danielecostarella/energy-harvesting-demoboard/hardware/PDF/energy-harvesting-demoboard_brd_v11.pdf

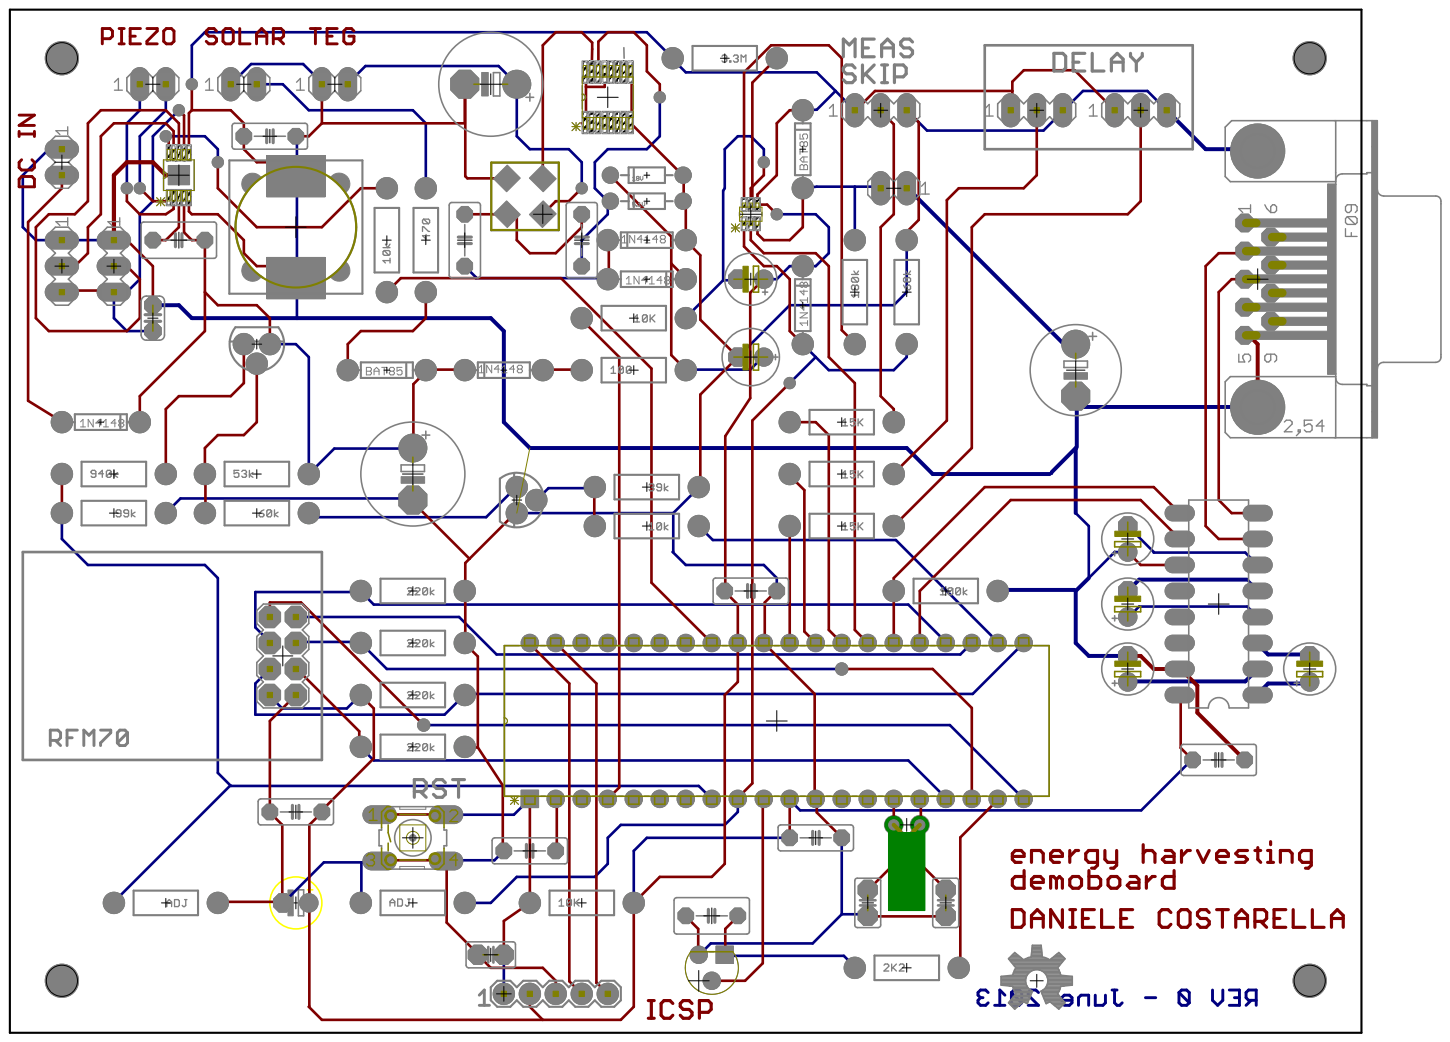
[picture p1: page 1]
