danielecostarella/energy-harvesting-demoboard/hardware/PDF/energy-harvesting-demoboard_v11.pdf

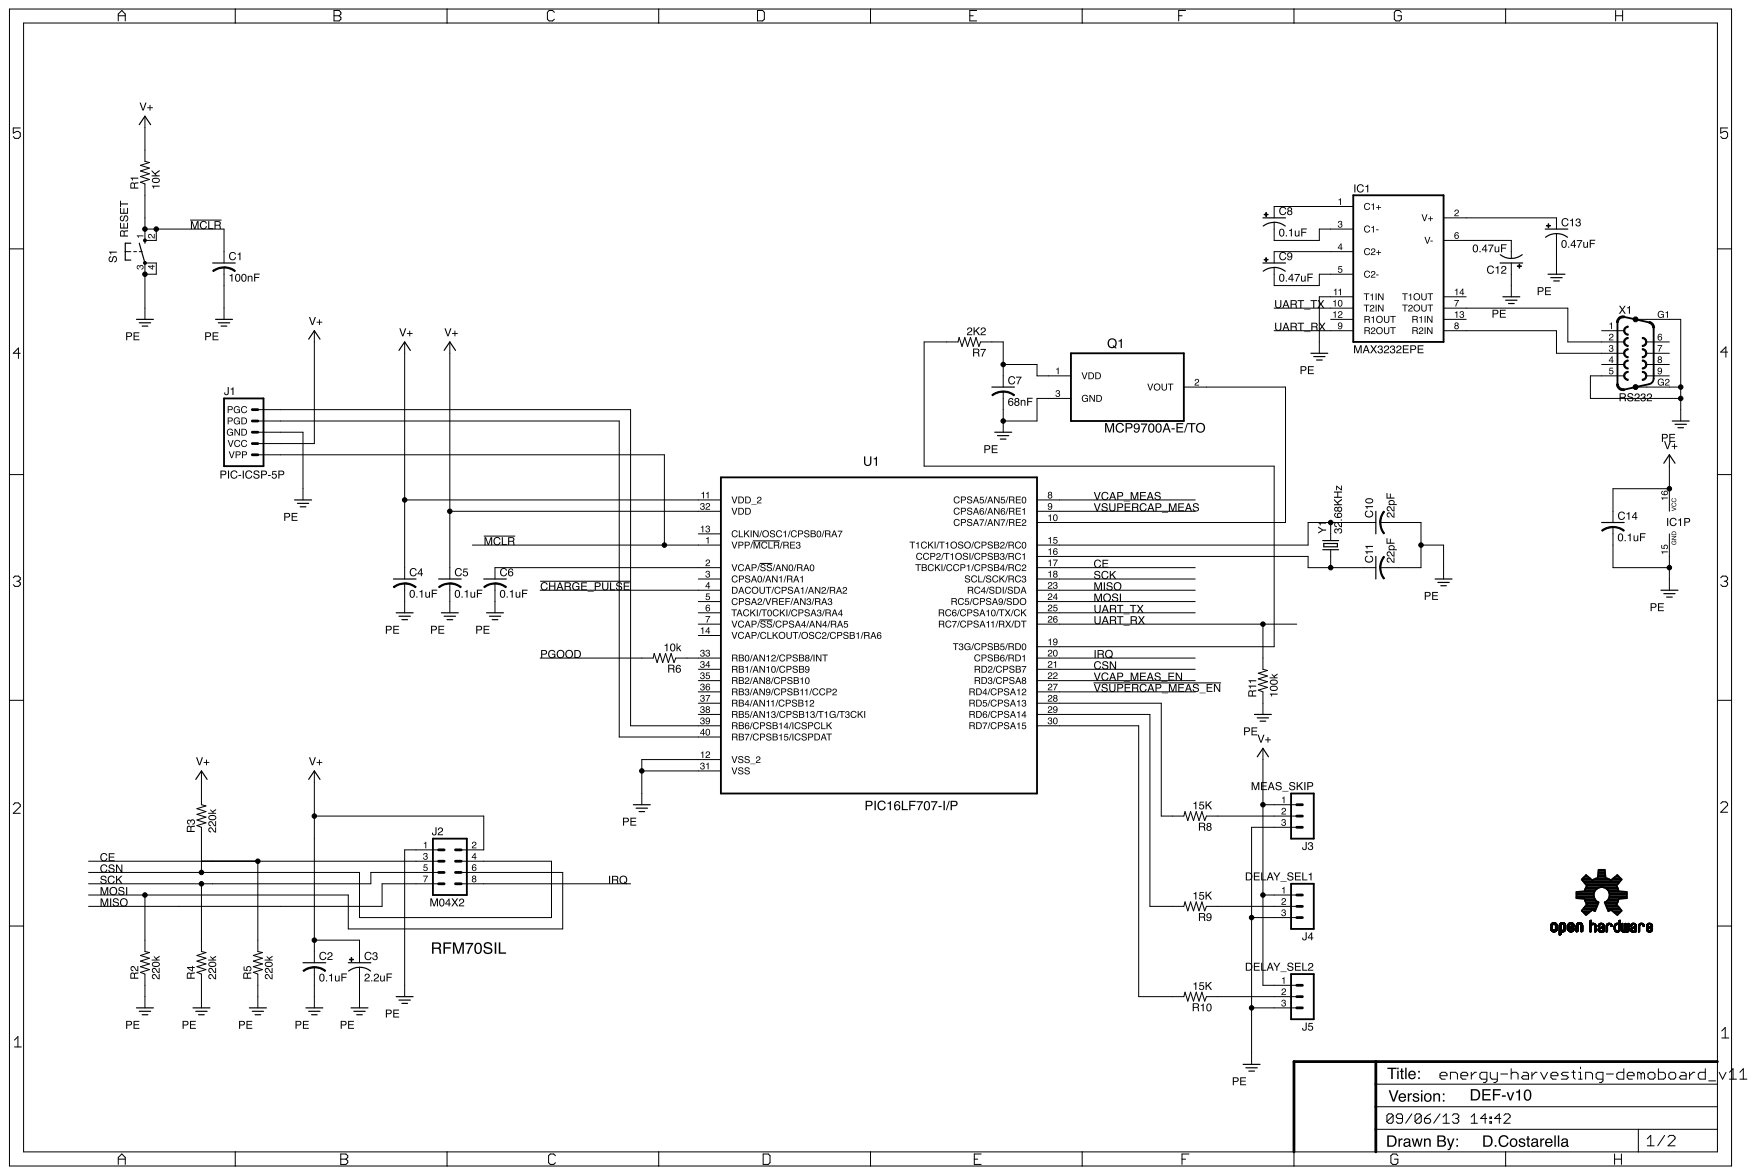
[picture p2: page 1]

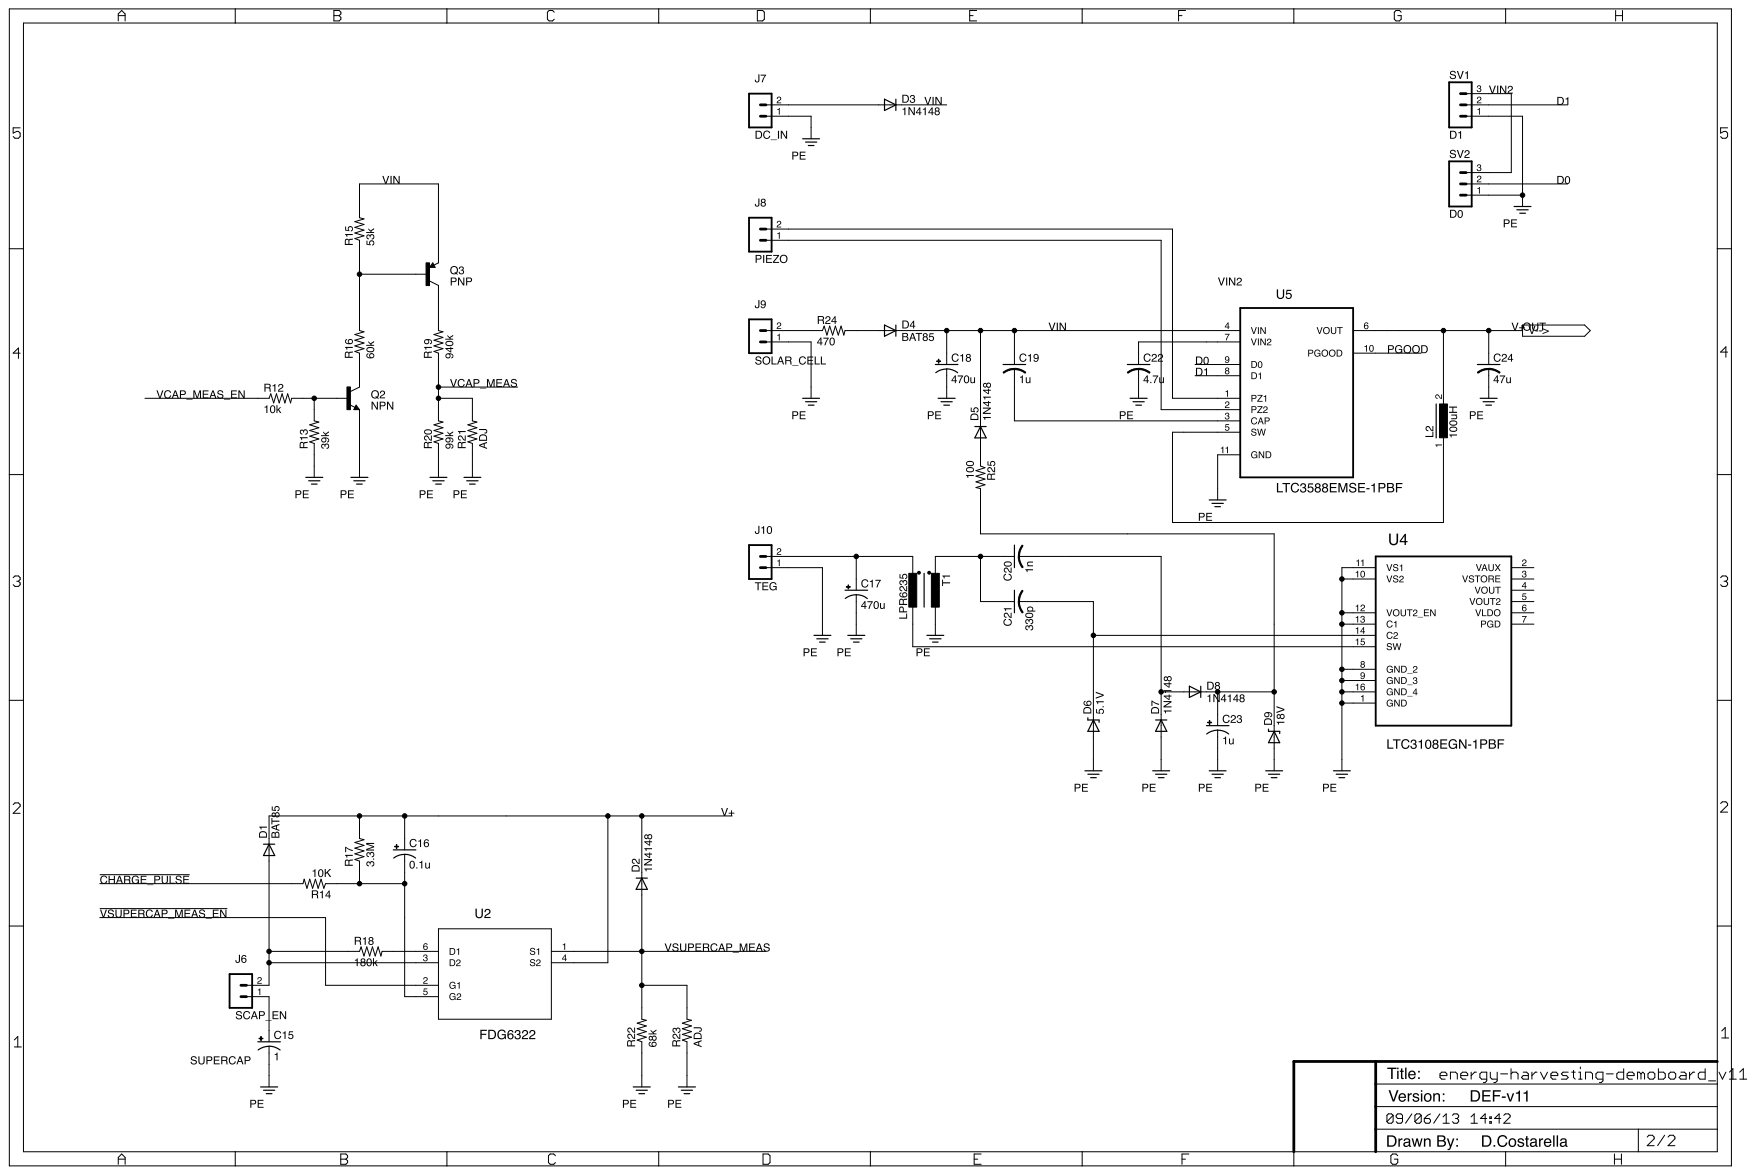
[picture p3: page 2]
