danielecostarella/energy-harvesting-demoboard/hardware/EAGLE/energy-harvesting-demoboard_v11.brd

## EAGLE design hardware/EAGLE/energy-harvesting-demoboard_v11.brd (2018-03-24)

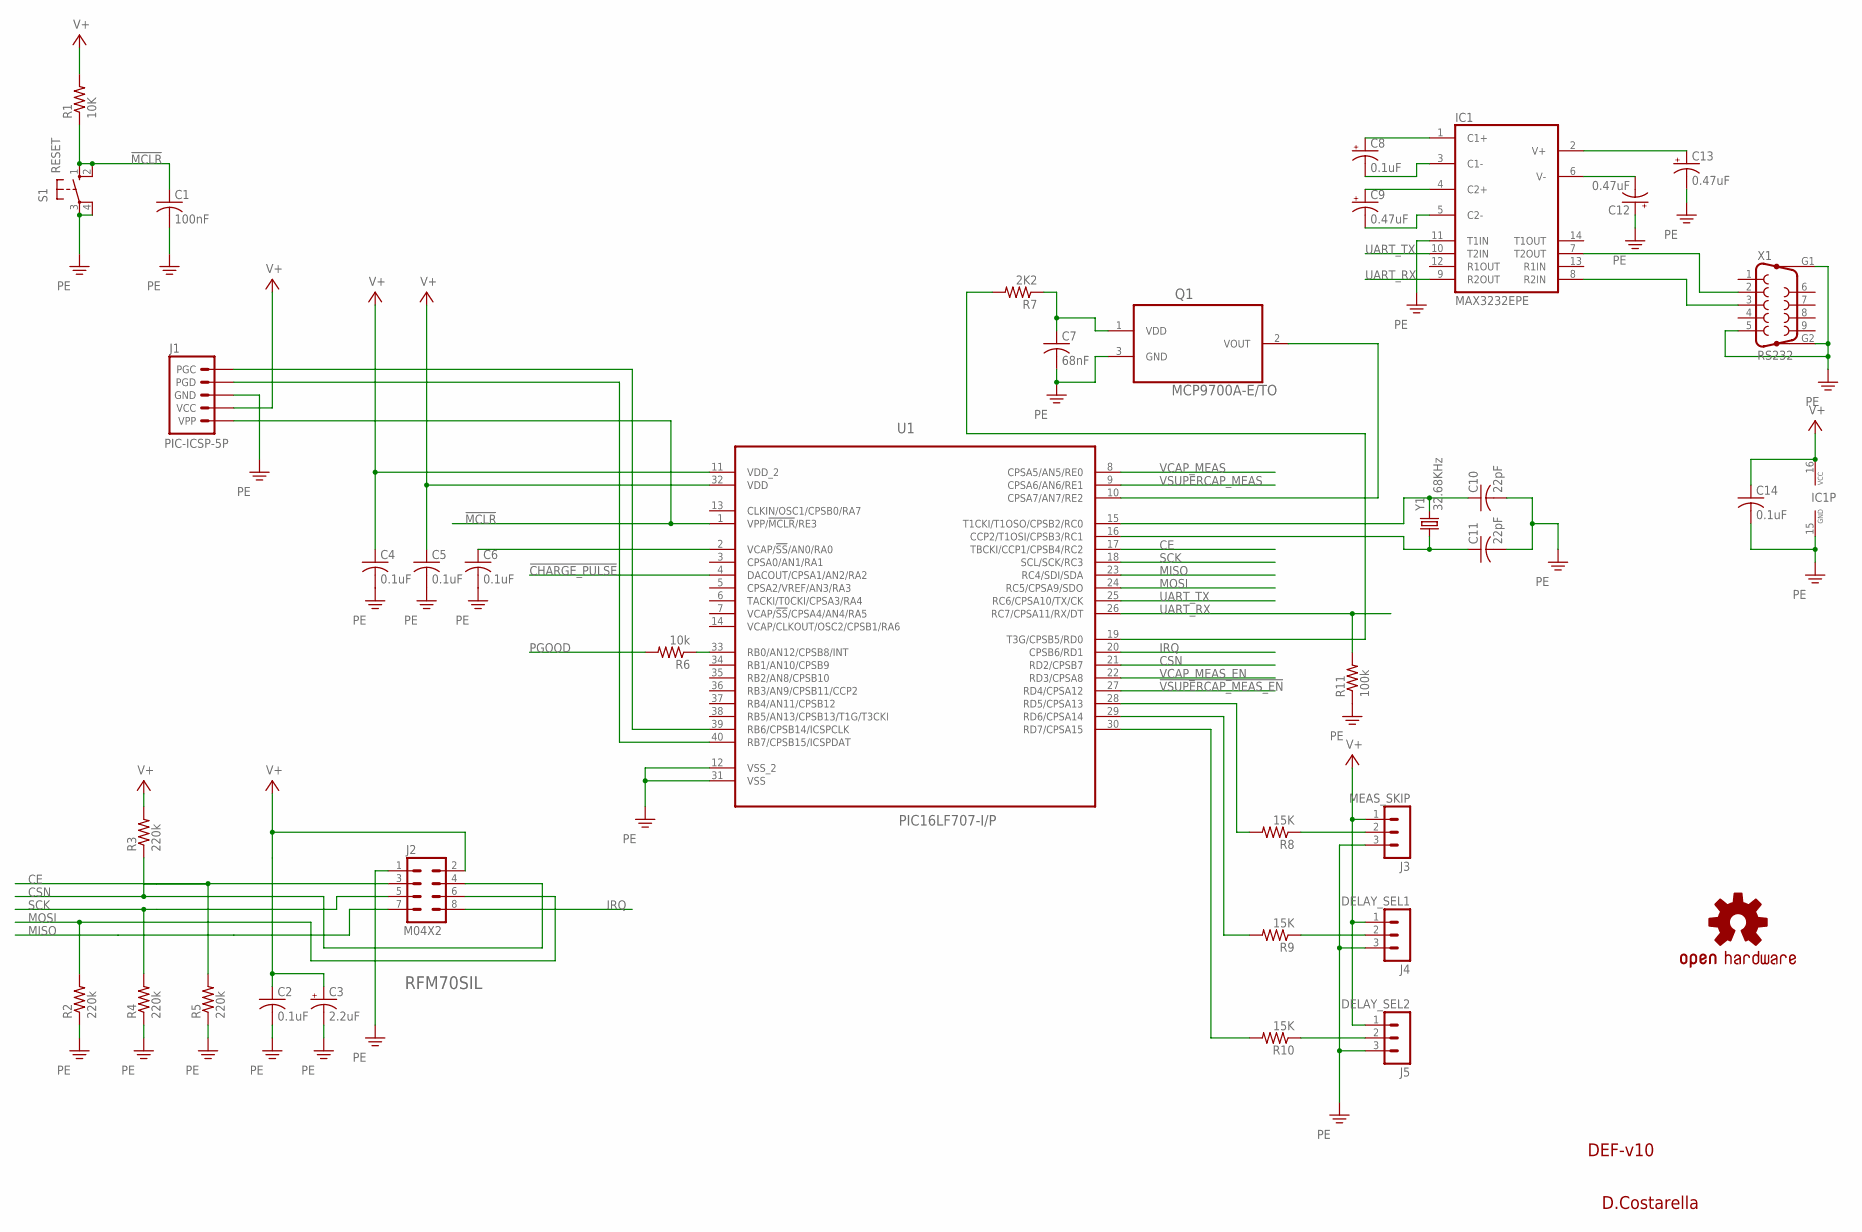
[picture p4: schematic energy-harvesting-demoboard_v11.sch, sheet 1]

Parts:
C1: 100nF; C025-025X050
C2, C4, C5, C6: 0.1uF; C050-025X075
C3: 2.2uF; E2,5-5
C7: 68nF; C050-035X075
C8: 0.1uF; E2,5-5
C9, C12, C13: 0.47uF; E2,5-5
C10, C11: 22pF; C025-025X050
C14: 0.1uF; C050-030X075
IC1: MAX3232EPE; DIL16
J1: PIC-ICSP-5P; 1X05
J2: M04X2; 2X4
J3: MEAS_SKIP; MA03-1
J4: DELAY_SEL1; MA03-1
J5: DELAY_SEL2; MA03-1
LOGO1: OSHW-LOGOL; OSHW-LOGO-L
Q1: MCP9700A-E/TO; TO127P254X533-3
R1: 10K; AXIAL-0.4
R2, R3, R4, R5: 220k; AXIAL-0.4
R6: 10k; AXIAL-0.4
R7: 2K2; AXIAL-0.4
R8, R9, R10: 15K; AXIAL-0.4
R11: 100k; AXIAL-0.4
S1: RESET; B3F-10XX
U1: PIC16LF707-I/P; DIP254P1524X635-40
X1: RS232; F09HP
Y1: 32.68KHz; TC26HEZ

Connections:
!CHARGE_PULSE: U1.4 (DACOUT/CPSA1/AN2/RA2); also elsewhere on the board
!MCLR: C1.1, J1.1 (VPP), R1.P$1 (1), S1.1 (S), S1.2 (S1), U1.1 (VPP/!MCLR!/RE3)
!VSUPERCAP_MEAS_EN: U1.27 (RD4/CPSA12); also elsewhere on the board
CE: J2.3, R5.P$2 (2), U1.17 (TBCKI/CCP1/CPSB4/RC2)
CSN: J2.4, R3.P$1 (1), U1.21 (RD2/CPSB7)
IRQ: J2.8, U1.20 (CPSB6/RD1)
MISO: J2.7, U1.23 (RC4/SDI/SDA)
MOSI: J2.6, R2.P$2 (2), U1.24 (RC5/CPSA9/SDO)
unnamed: J1.5 (PGC), U1.39 (RB6/CPSB14/ICSPCLK)
unnamed: J1.4 (PGD), U1.40 (RB7/CPSB15/ICSPDAT)
unnamed: C6.1, U1.2 (VCAP/!SS!/AN0/RA0)
unnamed: C10.1, U1.15 (T1CKI/T1OSO/CPSB2/RC0), Y1.2
unnamed: C11.1, U1.16 (CCP2/T1OSI/CPSB3/RC1), Y1.1
unnamed: Q1.2 (VOUT), U1.10 (CPSA7/AN7/RE2)
unnamed: J3.2, R8.P$1 (1)
unnamed: R8.P$2 (2), U1.28 (RD5/CPSA13)
unnamed: J4.2, R9.P$1 (1)
unnamed: J5.2, R10.P$1 (1)
unnamed: R9.P$2 (2), U1.29 (RD6/CPSA14)
unnamed: R10.P$2 (2), U1.30 (RD7/CPSA15)
unnamed: C7.1, Q1.1 (VDD), R7.P$1 (1)
unnamed: C8.+, IC1.1 (C1+)
unnamed: C8.-, IC1.3 (C1-)
unnamed: C9.+, IC1.4 (C2+)
unnamed: C9.-, IC1.5 (C2-)
unnamed: C12.-, IC1.6 (V-)
unnamed: C13.+, IC1.2 (V+)
unnamed: IC1.8 (R2IN), X1.3
unnamed: IC1.7 (T2OUT), X1.2
unnamed: R6.P$1 (1), U1.33 (RB0/AN12/CPSB8/INT)
PE: C1.2, C2.2, C3.-, C4.2, C5.2, C6.2, C7.2, C10.2, C11.2, C12.+, C13.-, C14.2, IC1.11 (T1IN), IC1.15 (GND), J1.3 (GND), J2.1, J3.3, J4.3, J5.3, Q1.3 (GND), R2.P$1 (1), R4.P$1 (1), R5.P$1 (1), R11.P$1 (1), S1.3, S1.4 (P1), U1.12 (VSS_2), U1.31 (VSS), X1.5, X1.G1, X1.G2; also elsewhere on the board
PGOOD: R6.P$2 (2); also elsewhere on the board
SCK: J2.5, R4.P$2 (2), U1.18 (SCL/SCK/RC3)
SENS_EN: R7.P$2 (2), U1.19 (T3G/CPSB5/RD0)
UART_RX: IC1.9 (R2OUT), R11.P$2 (2), U1.26 (RC7/CPSA11/RX/DT)
UART_TX: IC1.10 (T2IN), U1.25 (RC6/CPSA10/TX/CK)
V+: C2.1, C3.+, C4.1, C5.1, C14.1, IC1.16 (VCC), J1.2 (VCC), J2.2, J3.1, J4.1, J5.1, R1.P$2 (2), R3.P$2 (2), U1.11 (VDD_2), U1.32 (VDD); also elsewhere on the board
VCAP_MEAS: U1.8 (CPSA5/AN5/RE0); also elsewhere on the board
VCAP_MEAS_EN: U1.22 (RD3/CPSA8); also elsewhere on the board
VSUPERCAP_MEAS: U1.9 (CPSA6/AN6/RE1); also elsewhere on the board

Notes on the sheet:
DEF-v10
D.Costarella
RFM70SIL

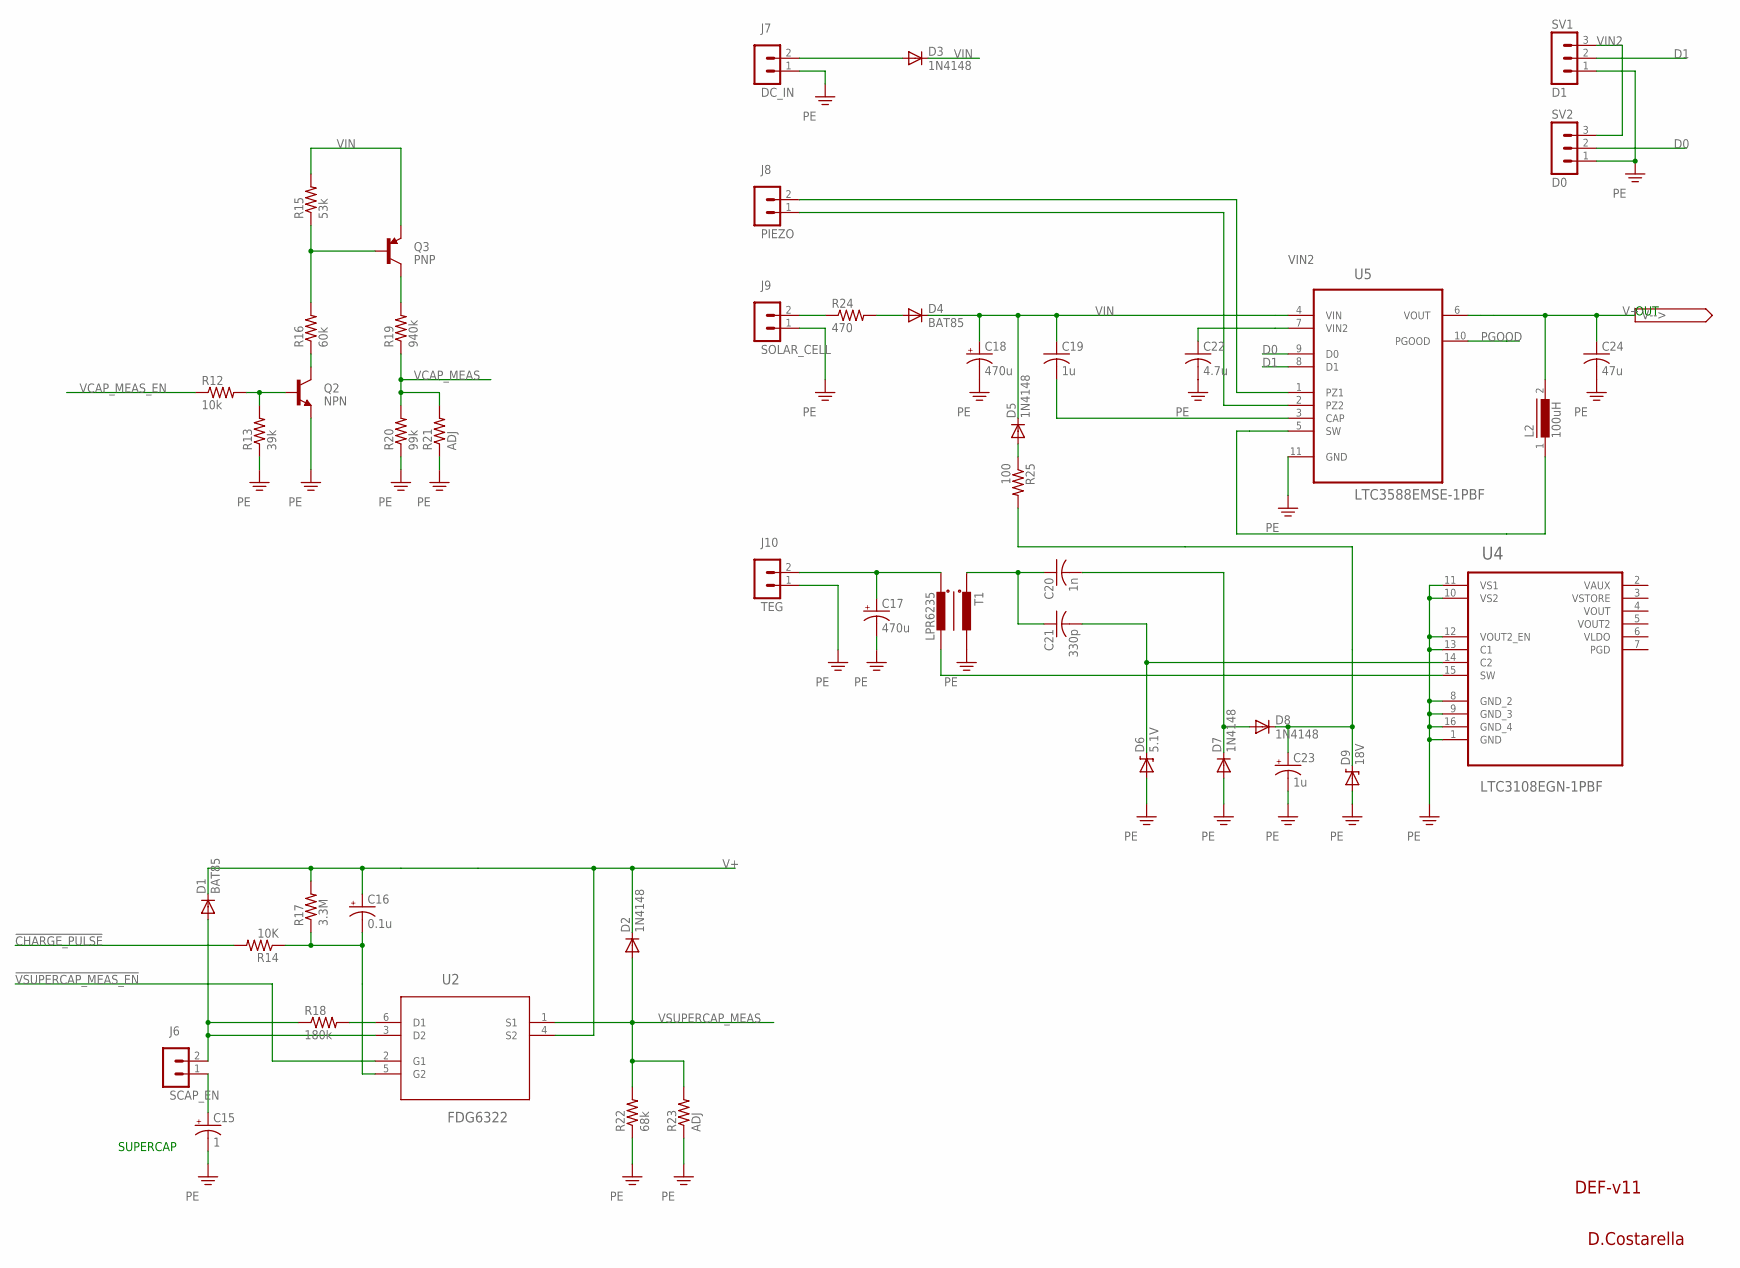
[picture p5: schematic energy-harvesting-demoboard_v11.sch, sheet 2]

Parts:
C15: 1; E5-8,5
C16: 0.1u; E2,5-5
C17, C18: 470u; E5-10,5
C19: 1u; C050-035X075
C20: 1n; C050-030X075
C21: 330p; C050-030X075
C22: 4.7u; C025-024X044
C23: 1u; E2,5-6E
C24: 47u; C050-025X075
D1, D4: BAT85; DIODE-1N4148
D2, D7, D8: 1N4148; DIODE-1N4148
D3, D5: 1N4148; SMA-DIODE
D6: 5.1V; DIODE-ZENER
D9: 18V; DIODE-ZENER
J6: SCAP_EN; MA02-1
J7: DC_IN; MA02-1
J8: PIEZO; MA02-1
J9: SOLAR_CELL; MA02-1
J10: TEG; MA02-1
L2: 100uH; DR125
Q2: NPN; TO-92
Q3: PNP; TO-92
R12: 10k; AXIAL-0.4
R13: 39k; AXIAL-0.4
R14: 10K; AXIAL-0.4
R15: 53k; AXIAL-0.4
R16: 60k; AXIAL-0.4
R17: 3.3M; AXIAL-0.4
R18: 180k; AXIAL-0.4
R19: 940k; AXIAL-0.4
R20: 99k; AXIAL-0.4
R21, R23: ADJ; AXIAL-0.4
R22: 68k; AXIAL-0.4
R24: 470; AXIAL-0.4
R25: 100; AXIAL-0.4
SV1: D1; MA03-1
SV2: D0; MA03-1
T1: LPR6235
U2: FDG6322; SOT65P210X110-6N
U4: LTC3108EGN-1PBF; SOP63P600X175-16N
U5: LTC3588EMSE-1PBF; SOP50P490X110-11N

Connections:
!CHARGE_PULSE: R14.P$2 (2); also elsewhere on the board
!VSUPERCAP_MEAS_EN: U2.2 (G1); also elsewhere on the board
D0: SV2.2, U5.9 (D0)
D1: SV1.2, U5.8 (D1)
unnamed: Q2.2 (B), R12.P$2 (2), R13.P$2 (2)
unnamed: Q2.1 (C), R16.P$1 (1)
unnamed: Q3.2 (B), R15.P$1 (1), R16.P$2 (2)
unnamed: J8.1, U5.2 (PZ2)
unnamed: Q3.3 (C), R19.P$2 (2)
unnamed: D1.A, J6.2, R18.P$1 (1), U2.3 (D2)
unnamed: R18.P$2 (2), U2.6 (D1)
unnamed: J9.2, R24.P$1 (1)
unnamed: J8.2, U5.1 (PZ1)
unnamed: L2.1, U5.5 (SW)
unnamed: C19.2, U5.3 (CAP)
unnamed: C15.+, J6.1
unnamed: C23.+, D8.C, D9.P$1 (C), R25.P$2 (2)
unnamed: C21.2, D6.P$1 (C), U4.14 (C2)
unnamed: D3.A, J7.2
unnamed: C17.+, J10.2, T1.P$1 (1)
unnamed: D5.A, R25.P$1 (1)
unnamed: C20.2, D7.C, D8.A
unnamed: C16.-, R14.P$1 (1), R17.P$1 (1), U2.5 (G2)
unnamed: D4.A, R24.P$2 (2)
unnamed: T1.P$2 (2), U4.15 (SW)
unnamed: C20.1, C21.1, T1.P$4 (4)
PE: C15.-, C17.-, C18.-, C22.2, C23.-, C24.2, D6.P$2 (A), D7.A, D9.P$2 (A), J7.1, J9.1, J10.1, Q2.3 (E), R13.P$1 (1), R20.P$1 (1), R21.P$1 (1), R22.P$1 (1), R23.P$1 (1), SV1.1, SV2.1, T1.P$3 (3), U4.1 (GND), U4.8 (GND_2), U4.9 (GND_3), U4.10 (VS2), U4.11 (VS1), U4.12 (VOUT2_EN), U4.13 (C1), U4.16 (GND_4), U5.11 (GND); also elsewhere on the board
PGOOD: U5.10 (PGOOD); also elsewhere on the board
V+: C16.+, C24.1, D1.C, D2.C, L2.2, R17.P$2 (2), U2.4 (S2), U5.6 (VOUT); also elsewhere on the board
VCAP_MEAS: R19.P$1 (1), R20.P$2 (2), R21.P$2 (2); also elsewhere on the board
VCAP_MEAS_EN: R12.P$1 (1); also elsewhere on the board
VIN: C18.+, C19.1, D3.C, D4.C, D5.C, Q3.1 (E), R15.P$2 (2), U5.4 (VIN)
VIN2: C22.1, SV1.3, SV2.3, U5.7 (VIN2)
VSUPERCAP_MEAS: D2.A, R22.P$2 (2), R23.P$2 (2), U2.1 (S1); also elsewhere on the board

Notes on the sheet:
OUT
SUPERCAP
DEF-v11
D.Costarella

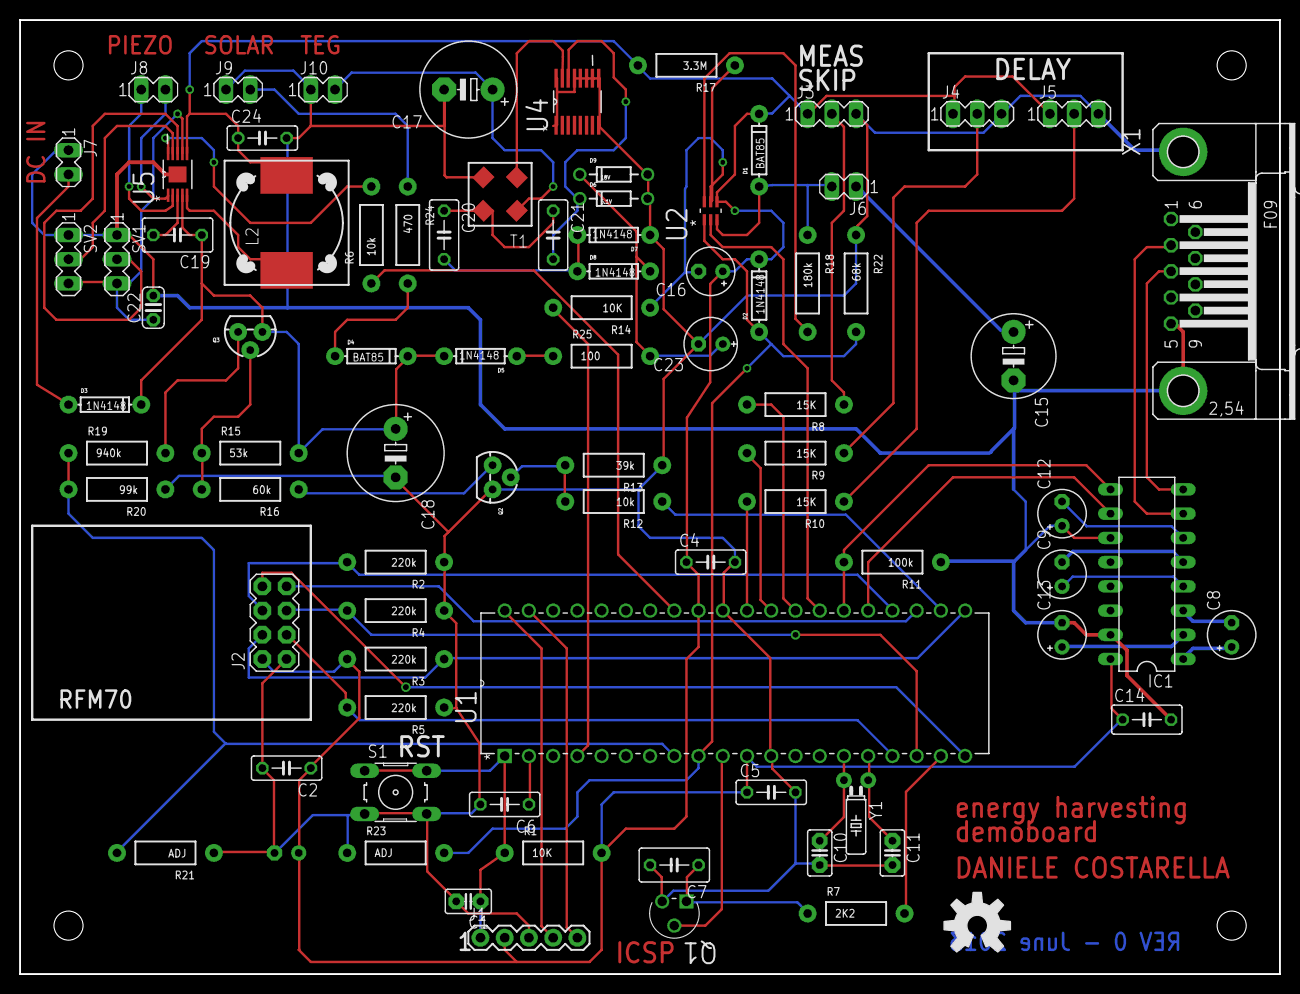
[picture p6: board energy-harvesting-demoboard_v11.brd from above]

Board: 2 copper layers, 132.1 x 100.0 mm, 84 parts (1 on the bottom side), 66 nets.
