danielecostarella/energy-harvesting-demoboard/firmware/rfm70.c

/*****************************************************************************
 * File:        rfm70.c
 *
 * Compiler:    Microchip XC8 v1.12 or higher
 *
 * Released on: June, 2013
 *
 *****************************************************************************
 * File description:
 *
 * Energy Harvesting Demoboard firmware
 * RFM70 radio module driver for PIC16
 *
 * For new versions of this code please visit:
 * https://github.com/danielecostarella/energy-harvesting-demoboard
 *
 * Detailed information can also be found on my master thesis [IT]
 *
 *****************************************************************************/

/********************************** HEADERS **********************************/
#include <stdio.h>
#include <stdlib.h>
#include "rfm70.h"
#include "main.h"


/*****************************************************************************/
// Bank1 register init values
/*****************************************************************************/
const unsigned long Bank1_Reg0_13[]={       //latest config txt
    0xE2014B40,
    0x00004BC0,
    0x028CFCD0,
    0x41390099,
    0x0B869Ef9,
    0xA67F0624,
    0x00000000,
    0x00000000,
    0x00000000,
    0x00000000,
    0x00000000,
    0x00000000,
    0x00127300,
    0x36B48000,
};

const uint8_t Bank1_Reg14[]=
{
	0x41,0x20,0x08,0x04,0x81,0x20,0xCF,0xF7,0xFE,0xFF,0xFF
};


/*****************************************************************************/
// Bank0 register init values
/*****************************************************************************/
const uint8_t Bank0_Reg[][2]={
    {0,0x0F},   // reflect RX_DR\TX_DS\MAX_RT, Enable CRC , 2byte, POWER UP, PRX
    {1,0x3F},   // Enable auto acknowledgement data pipe5\4\3\2\1\0
    {2,0x3F},   // Enable RX Addresses pipe5\4\3\2\1\0
    {3,0x03},   // RX/TX address field width 5 byte
    {4,0xFF},   // auto retransmission delay (4000us),auto retransmission count(15)
    {5,0x17},   // Channel: 23
    {6,0x01},   // air data rate-1M,out power 0dbm,setup LNA gain
    {7,0x07},
    {8,0x00},
    {9,0x00},
    {12,0xc3},  // Only LSB Receive address data pipe 2, MSB bytes is equal to
                // RX_ADDR_P1[39:8]
    {13,0xc4},  // Only LSB Receive address data pipe 3, MSB bytes is equal to
                // RX_ADDR_P1[39:8]
    {14,0xc5},  // only LSB Receive address data pipe 4, MSB bytes is equal to
                // RX_ADDR_P1[39:8]
    {15,0xc6},  // only LSB Receive address data pipe 5, MSB bytes is equal to
                // RX_ADDR_P1[39:8]
    {17,0x20},  // Number of bytes in RX payload in data pipe0 (32 byte)
    {18,0x20},  // Number of bytes in RX payload in data pipe1 (32 byte)
    {19,0x20},  // Number of bytes in RX payload in data pipe2(32 byte)
    {20,0x20},  // Number of bytes in RX payload in data pipe3(32 byte)
    {21,0x20},  // Number of bytes in RX payload in data pipe4(32 byte)
    {22,0x20},  // Number of bytes in RX payload in data pipe5(32 byte)
    {23,0x00},  // FIFO status
    {28,0x3F},  // Enable dynamic payload length data pipe5\4\3\2\1\0
    {29,0x07}   // Enables Dynamic Payload Length,Enables Payload with ACK,Enables
                // the W_TX_PAYLOAD_NOACK command
};

const uint8_t Bank0_RegAct[2][2] = {
    {DYNPD, 0x3F},
    {FEATURE, 0x07}
};
/* Receive address data p0 */
const uint8_t RX0_Address[]={0x34,0x43,0x10,0x10,0x01};

/* Receive address data p1 */
const uint8_t RX1_Address[]={0x39,0x38,0x37,0x36,0xc2};


/*****************************************************************************/
// SPI access
/*****************************************************************************/
uint8_t SPI_RW(uint8_t value)
{
	SSPBUF = value;		// send data via SPI - put in SPI Data Register
        WAIT_MS(1);
	while(!PIR1bits.SSPIF); // wait for SPI interrupt flag indicating
                                // transmit complete
        //WAIT_MS(1);
	return SSPBUF;          // return value in SPI Data Register
}


/*****************************************************************************
 * Function: SPI_Write_Reg()
 * Description:     Writes value 'value' to register 'reg'
 * Parameter:       reg to be write, value
 *
 *
 * Return:          None
 *****************************************************************************/
void SPI_Write_Reg(uint8_t reg, uint8_t value)
{
	CSN=0;                  // CSN low, init SPI transaction
	SPI_RW(reg);     	// select register
	SPI_RW(value);          // ..and write value to it
	CSN=1;                  // Then, CSN high again
}


/*****************************************************************************
 * Function: SPI_Read_Reg()
 * Description:     Read one uint8_t from BK2421 register, 'reg'
 * Parameter:       reg to be read
 *
 *
 * Return:          None
 *****************************************************************************/
uint8_t SPI_Read_Reg(uint8_t reg)
{
	uint8_t value;
	CSN=0;                  // CSN low, initialize SPI communication...
	SPI_RW(reg);            // Select register to read from
	value = SPI_RW(0);    	// Read register value
	CSN=1;                  // CSN high, terminate SPI communication

	return(value);        	// Return register value
}


/*****************************************************************************
 * Function: SPI_Read_Buf()
 * Description:     Reads 'length' #of length from register 'reg'
 * Parameter:       reg, pointer to Buffer, length
 *
 *
 * Return:          None
 *****************************************************************************/
void SPI_Read_Buf(uint8_t reg, uint8_t *pBuf, uint8_t length)
{
	uint8_t status,byte_ctr;

	CSN=0;                    	// Set CSN l
	status = SPI_RW(reg);           // Select register to write, and
                                        // read status uint8_t

        /* Perform SPI_RW to read uint8_t from RFM70 */
	for(byte_ctr=0;byte_ctr<length;byte_ctr++)
		pBuf[byte_ctr] = SPI_RW(0);

	CSN=1;                  	// Set CSN high again

}

/*****************************************************************************
 * Function: SPI_Write_Buf()
 * Description:     Writes contents of buffer '*pBuf' to RFM70
 * Parameter:       reg to be write, pointer to Buffer, length
 *
 *
 * Return:          None
 *****************************************************************************/
void SPI_Write_Buf(uint8_t reg, uint8_t *pBuf, uint8_t length)
{
	uint8_t byte_ctr;

	CSN=0;                          // Set CSN low, init SPI tranaction
	SPI_RW(reg);                    // Select register to write to and
                                        // read status uint8_t
        /* then write all uint8_t to buffer(*pBuf) */
	for(byte_ctr=0; byte_ctr<length; byte_ctr++)
		SPI_RW(*pBuf++);
	CSN=1;                          // Set CSN high again

}

/*****************************************************************************
 * Function: SwitchToRxMode()
 * Description:     switch to Rx mode
 * Parameter:       None
 *
 *
 * Return:          None
 *****************************************************************************/
void SwitchToRxMode()
{
	uint8_t value;

	SPI_Write_Reg(FLUSH_RX,0);      // Flush RX

	value=SPI_Read_Reg(STATUS);	// Read register STATUS's value
	SPI_Write_Reg(WRITE_REG|STATUS,value);
                                        // clear RX_DR or TX_DS or MAX_RT
                                        // interrupt flag

	CE=0;

	value=SPI_Read_Reg(CONFIG);	// Read register CONFIG's value

	value=value|0x01;               // Set bit 1
  	SPI_Write_Reg(WRITE_REG | CONFIG, value);
                                        // Set PWR_UP bit, enable
                                        // CRC(2 length)
	CE=1;
}


/*****************************************************************************
 * Function: SwitchToTxMode()
 * Description:     switch to Tx mode
 * Parameter:       None
 *
 *
 * Return:          None
 *****************************************************************************/
void SwitchToTxMode()
{
	uint8_t value;
	SPI_Write_Reg(FLUSH_TX,0);      //flush TX

	CE=0;
	value=SPI_Read_Reg(CONFIG);	// read register CONFIG's value

	value=value&0xfe;               // Set bit 0
  	SPI_Write_Reg(WRITE_REG | CONFIG, value);
                                        // Set PWR_UP bit, enable
                                        // CRC(2 length) & Prim:RX.
                                        // RX_DR enabled.
	CE=1;
}

/*****************************************************************************
 * Function: SwitchCFG()
 * Description:     switch between Bank1 and Bank0
 * Parameter:       _cfg      1:register bank1
 *                            0:register bank0
 *
 *
 * Return:          None
 *****************************************************************************/
void SwitchCFG(char _cfg)
{
	uint8_t Tmp;

	Tmp=SPI_Read_Reg(7);
	Tmp=Tmp&0x80;

	if( ( (Tmp)&&(_cfg==0) )
	||( ((Tmp)==0)&&(_cfg) ) )
	{
		SPI_Write_Reg(ACTIVATE_CMD,0x53);
	}
}


/*****************************************************************************
 * Function: SetChannelNum()
 * Description:     set channel number
 * Parameter:       ch: selected channel
 *
 *
 * Return:          None
 *****************************************************************************/
void SetChannelNum(uint8_t ch)
{
	SPI_Write_Reg((uint8_t)(WRITE_REG|5),(uint8_t)(ch));
}


/*************************** RFM70  Initialization ***************************/

/*****************************************************************************
 * Function: RFM70_Initialize()
 * Description:     RFM70 init. Executes registers init
 * Parameter:       None
 *
 *
 * Return:          None
 *****************************************************************************/
void RFM70_Initialize()
{
	uint8_t i,j;
 	uint8_t WriteArr[12];

	WAIT_MS(200);

	SwitchCFG(0);

	for(i=0;i<20;i++)
	{
		SPI_Write_Reg((WRITE_REG|Bank0_Reg[i][0]),Bank0_Reg[i][1]);
	}

/*//reg 10 - Rx0 addr
	SPI_Write_Buf((WRITE_REG|10),RX0_Address,5);

//REG 11 - Rx1 addr
	SPI_Write_Buf((WRITE_REG|11),RX1_Address,5);

//REG 16 - TX addr
	SPI_Write_Buf((WRITE_REG|16),RX0_Address,5);*/

        /* REG 10 - Rx0 addr */
	for(j=0;j<5;j++)
	{
		WriteArr[j]=RX0_Address[j];
	}
	SPI_Write_Buf((WRITE_REG|10),&(WriteArr[0]),5);

        /* REG 11 - Rx1 addr */
	for(j=0;j<5;j++)
	{
		WriteArr[j]=RX1_Address[j];
	}
	SPI_Write_Buf((WRITE_REG|11),&(WriteArr[0]),5);
        /* REG 16 - TX addr */
	for(j=0;j<5;j++)
	{
		WriteArr[j]=RX0_Address[j];
	}
	SPI_Write_Buf((WRITE_REG|16),&(WriteArr[0]),5);

	///printf("\nEnd Load Reg");

	i=SPI_Read_Reg(29);     //read Feature Register
	if(i==0)                // i!=0 showed that chip has been actived.
                                // so do not active again.
		SPI_Write_Reg(ACTIVATE_CMD,0x73); // Active
        //for (i=0;i<2;i++) {
        //    SPI_Write_Reg(WRITE_REG|Bank0_RegAct[i][0], Bank0_RegAct[i][1]);
        //    SPI_Read_Reg(Bank0_RegAct[i][0]);
        //}


	for(i=22;i>=21;i--)
	{
		SPI_Write_Reg((WRITE_REG|Bank0_Reg[i][0]),Bank0_Reg[i][1]);
		//SPI_Write_Reg_Bank0(Bank0_Reg[i][0],Bank0_Reg[i][1]);
	}
        /*********************************************************************/
        // Write Bank1 register
        /*********************************************************************/
	SwitchCFG(1);

	for(i=0;i<=8;i++)       // Reverse
	{
		for(j=0;j<4;j++)
			WriteArr[j]=(Bank1_Reg0_13[i]>>(8*(j) ) )&0xff;

		SPI_Write_Buf((WRITE_REG|i),&(WriteArr[0]),4);
	}

	for(i=9;i<=13;i++)
	{
		for(j=0;j<4;j++)
			WriteArr[j]=(Bank1_Reg0_13[i]>>(8*(3-j) ) )&0xff;

		SPI_Write_Buf((WRITE_REG|i),&(WriteArr[0]),4);
	}

	//SPI_Write_Buf((WRITE_REG|14),&(Bank1_Reg14[0]),11);
	for(j=0;j<11;j++)
	{
		WriteArr[j]=Bank1_Reg14[j];
	}
	SPI_Write_Buf((WRITE_REG|14),&(WriteArr[0]),11);

        /* toggle REG4<25,26> */
	for(j=0;j<4;j++)
		//WriteArr[j]=(RegArrFSKAnalog[4]>>(8*(j) ) )&0xff;
		WriteArr[j]=(Bank1_Reg0_13[4]>>(8*(j) ) )&0xff;

	WriteArr[0]=WriteArr[0]|0x06;
	SPI_Write_Buf((WRITE_REG|4),&(WriteArr[0]),4);

	WriteArr[0]=WriteArr[0]&0xf9;
	SPI_Write_Buf((WRITE_REG|4),&(WriteArr[0]),4);

	WAIT_MS(50);

        /*********************************************************************/
        // Switch back to Bank0 register access
        /*********************************************************************/
	SwitchCFG(0);
	//SwitchToRxMode();     //switch to RX mode
        CE=0;
}


uint8_t rfm70_data_sent(void) {
    if (SPI_Read_Reg(STATUS)&STATUS_TX_DS) {
        SPI_Write_Reg(WRITE_REG|STATUS,STATUS_TX_DS);
        return(1);
    }
    else
        return(0);
}

uint8_t rfm70TxDataSentInterrupt(void) {
    if (SPI_Read_Reg(STATUS)&STATUS_TX_DS) {
        SPI_Write_Reg(WRITE_REG|STATUS,STATUS_TX_DS);
        return(1);
    }
    else
        return(0);
}

uint8_t rfm70TxDataSentErrorInterrupt(void) {
    if (SPI_Read_Reg(STATUS)&STATUS_TX_DS) {
        SPI_Write_Reg(WRITE_REG|STATUS,STATUS_MAX_RT);
        return(1);
    }
    else
        return(0);
}

uint8_t rfm70Interrupt(void) {
    if (IRQ)
        return(0);
    else
        return(1);
}

/*****************************************************************************
 * Function: Rrfm70setPowerdownMode
 * Description:     Switch the RFM70 from StandBy to Power Down mode and
 *                  viceversa
 * Parameter:       value   1 -> StandBy
 *                          0 -> Power Down
 *
 *
 * Return:          None
 *****************************************************************************/
void rfm70setPowerdownMode(uint8_t value)
{
	uint8_t reg;

	reg=SPI_Read_Reg(CONFIG);   // read register CONFIG reg value
	//SPI_Write_Reg(WRITE_REG|STATUS,value);
                                    // clear RX_DR or TX_DS or MAX_RT
                                    // interrupt flag

        if (value==0) {
            reg &= 0xFD;            // clear bit 1
        }
        else {
            reg |= 0x02;            //set bit 1
        }

  	SPI_Write_Reg(WRITE_REG | CONFIG, reg);
}
