danielecostarella/energy-harvesting-demoboard/(commit log)

2013-02-15 Added 'DEFINE' for SPI commands in rfm70.h
2013-03-03 ISR and ADC working. New processor PIC16F707
    [energy-harvesting-demoboard.production.obj]
2013-03-04 Riduzione ritardi e test oscilloscopio
    [energy-harvesting-demoboard.production.obj]
2013-03-08 Added MCP9700A + code
    [energy-harvesting-demoboard.production.obj]
2013-03-08 Added Vcap check, send temperature and vcap to be converted on the receiver side (40-50 uA in sleep mode)
    [energy-harvesting-demoboard.production.obj]
2013-03-08 Added Vstorage check before rfm70 init
    [energy-harvesting-demoboard.production.obj]
2013-03-08 Risolto bug alla funzione powerdown() che faceva consumare alternativamente 100uA/40uA al power-up
    [energy-harvesting-demoboard.production.obj]
2013-03-10 Added SLEEPCOUNT. The node send values together with the number (16 bit) of that acquisition
    [energy-harvesting-demoboard.production.obj]
2013-03-12 Regolazione ritarti, rivisto il contatore per il numero del pacchetto inviato
    [energy-harvesting-demoboard.production.obj]
2013-03-12 Aggiunto controllo ritardi, pin per il salto del controllo sulla tensione Vstorage, eliminato LED e spostato pin di alimentazione dell'mcp9700a da RE1 a RD0 (ex LED_PIN). Aggiunto invio dello status 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
    [energy-harvesting-demoboard.production.obj]
2013-03-14 Pin non utilizzati impostati come uscite nulle, ridotto il ritardo della funzione SPI_RW
    [energy-harvesting-demoboard.production.obj]
2013-03-17 Aggiunta funzionel sleep() con possibilità di impulso di carica in attesa di futura modulazione
    [energy-harvesting-demoboard.production.obj]
2013-03-20 Inserita direttiva #DEFINE per tensioni di soglia + modifica calcolo energia
    [energy-harvesting-demoboard.production.obj]
2013-04-24 DAC config added
    [energy-harvesting-demoboard.production.obj, test_1503.X.production.obj]
2013-05-02 Passaggio a PIC16LF707.
    [energy-harvesting-demoboard.production.obj]
2013-05-11 Somma dell'energia per invii successivi, invio dello stato dei DIP Switch corretto, carica attraverso il MOSFET e DAC, consumo 20uA
    [energy-harvesting-demoboard.production.obj]
2013-05-12 Aggiunta algoritmo di carica per SUPERCAP
    [energy-harvesting-demoboard.production.obj]
2013-05-13 Rimosso codice per far rimanere il MOS sempre ON
    [energy-harvesting-demoboard.production.obj]
2013-05-13 Risolto bug al controllo dell'impulso di carica
    [energy-harvesting-demoboard.production.obj]
2013-05-14 Nuovo algoritmo basato su percentuale per lunghezza dell'impulso di carica
    [energy-harvesting-demoboard.production.obj]
2013-05-20 Aggiunto bit di status per la presenza dell'alimentazione. Ora il nodo è in grado di avviarsi grazie al solo supercondensatore se opportunamente carico.
    [energy-harvesting-demoboard.production.obj]
2013-05-21 Misura del supercap con MOS ON; FVR Ready bit per le misure fatte dall'ADC; miglioramento dell'algoritmo per la riattivazione con power supply
    [energy-harvesting-demoboard.production.obj]
2013-05-26 PGOOD su RB0; gestione dell'invio quando scampare la tensione (c'era un bug che portava a un picco sul primo invio in backup); temp => energy; risolto il problema dell'accumulo dei valori di energia 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
    [energy-harvesting-demoboard.production.obj]
2013-05-26 Il byte jumper-stat contiene ora anche PGOOD (bit 6)
    [energy-harvesting-demoboard.production.obj]
2013-05-26 Riferimento di tensione (FVR) attivo 'solo' durante le misure => ottenuto ulteriore riduzione di corrente assorbita
    [energy-harvesting-demoboard.production.obj]
2013-05-28 Pulizia del codice, rimozione di alcuni commenti, aggiunti define, funzione boardInit per la configurazione dei pin
    [energy-harvesting-demoboard.production.obj]
2013-05-29 Nuova Define TX_PACKET_LEN, rimossa funzione adcRead inutilizzata, pulizia codice
    [energy-harvesting-demoboard.production.obj]
2013-06-08 Pulizia codice
    [energy-harvesting-demoboard.production.obj]
2013-06-09 Ora invia anche il pacchetto 0; invio anche quando la tensione Vin sta salendo
    [energy-harvesting-demoboard.production.obj]
2013-06-26 Release version
    [energy-harvesting-demoboard.production.obj]
2018-03-21 Updated project description in README file
    [test_1503.X.production.obj]
2018-03-21 Update project description in README file
    [test_1503.X.production.obj]
2018-03-21 Remove built files
    [energy-harvesting-demoboard.production.obj]
2018-03-24 Add board gerber files
    [energy-harvesting-demoboard_v11.GBL, energy-harvesting-demoboard_v11.GBS, energy-harvesting-demoboard_v11.GKO, energy-harvesting-demoboard_v11.GTL, energy-harvesting-demoboard_v11.GTO, energy-harvesting-demoboard_v11.GTS]
2018-03-24 Add schematics and board Eagle files
    [energy-harvesting-demoboard_v11.brd, energy-harvesting-demoboard_v11.sch]
2018-03-24 Add schematics and board file exported to PDF
